DPIclimate/enviro-node/electronics/mounting/case-connector.kicad_pcb

## KiCad design electronics/mounting/case-connector.kicad_pcb (2022-11-08)

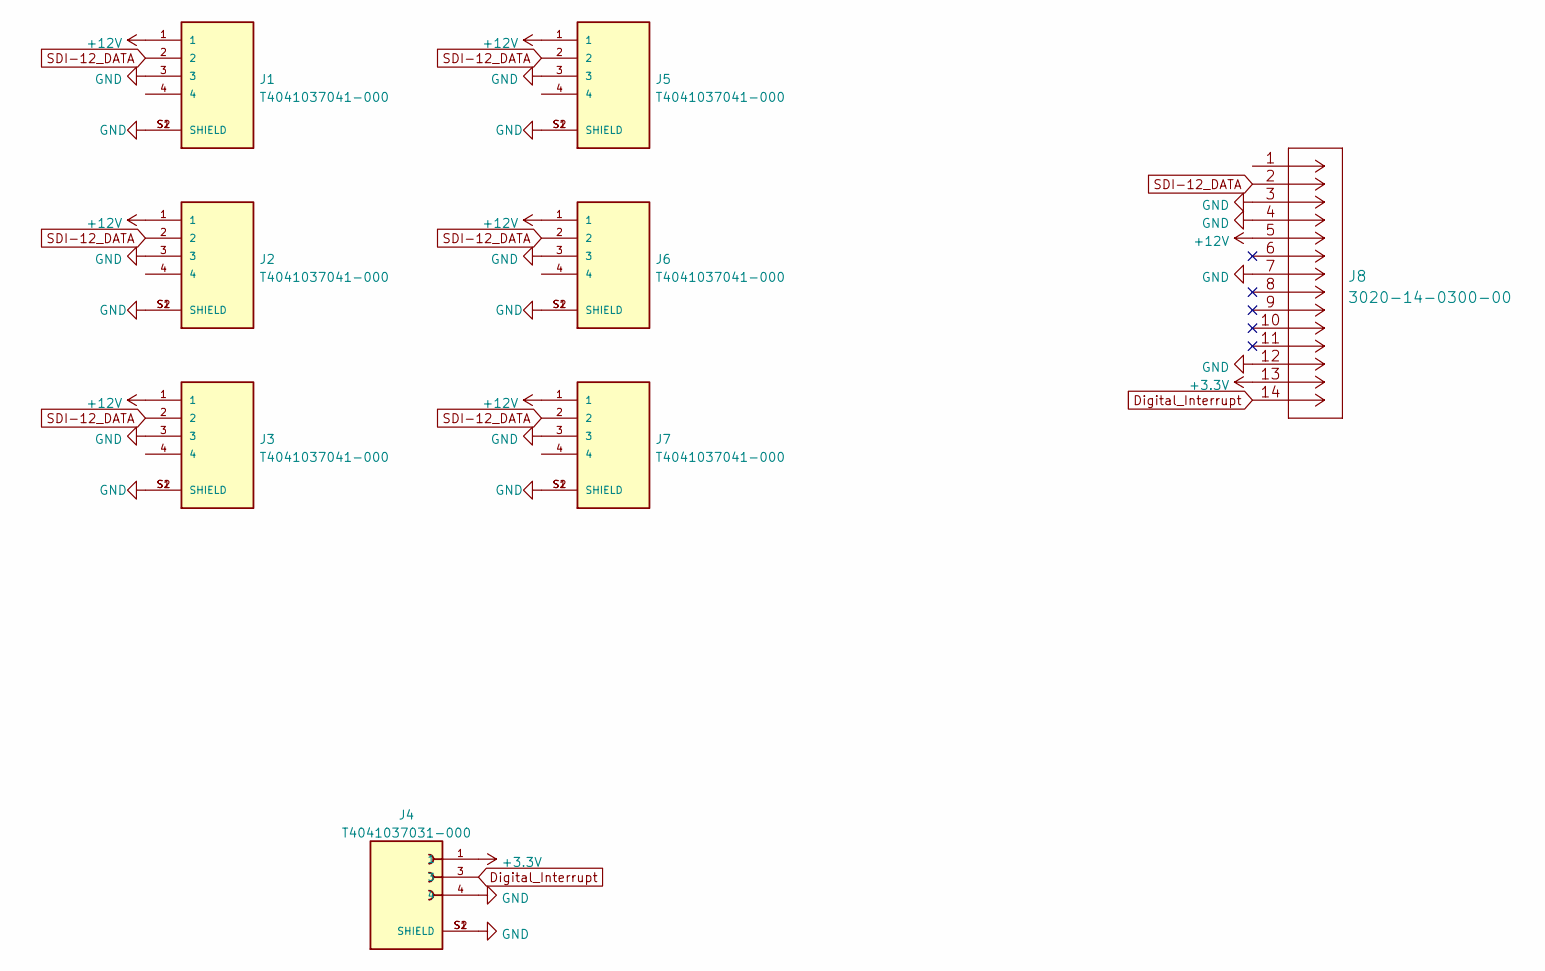
[picture p6: schematic case-connector.kicad_sch]

Parts:
J1, J2, J3, J5, J6, J7: T4041037041-000; TE_T4041037041-000
J4: T4041037031-000; TE_T4041037031-000
J8: 3020-14-0300-00

Connections:
+3.3V: J4.1, J8.13
+12V: J1.1, J2.1, J3.1, J5.1, J6.1, J7.1, J8.5
Digital_Interrupt: J4.3, J8.14
GND: J1.3, J1.S1 (SHIELD), J1.S2 (SHIELD), J2.3, J2.S1 (SHIELD), J2.S2 (SHIELD), J3.3, J3.S1 (SHIELD), J3.S2 (SHIELD), J4.4, J4.S1 (SHIELD), J4.S2 (SHIELD), J5.3, J5.S1 (SHIELD), J5.S2 (SHIELD), J6.3, J6.S1 (SHIELD), J6.S2 (SHIELD), J7.3, J7.S1 (SHIELD), J7.S2 (SHIELD), J8.3, J8.4, J8.7, J8.12
SDI-12_DATA: J1.2, J2.2, J3.2, J5.2, J6.2, J7.2, J8.2
