DPIclimate/enviro-node/electronics/mounting/case-connector.kicad_pcb

## KiCad design electronics/mounting/case-connector.kicad_pcb (continued)

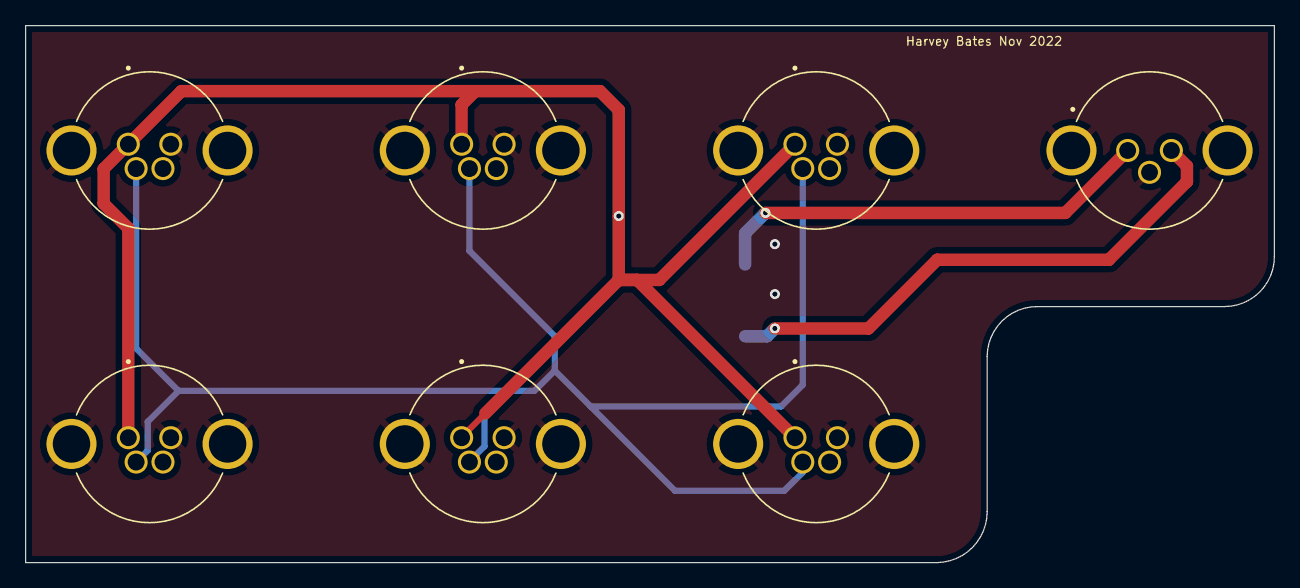
[picture p7: board case-connector.kicad_pcb from above]

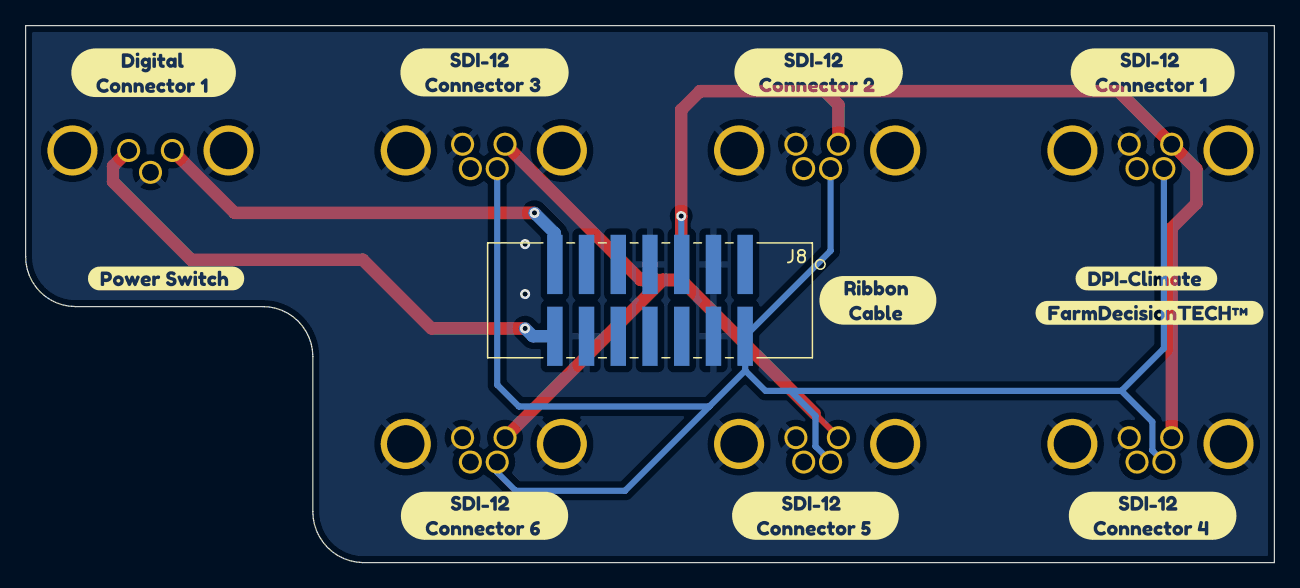
[picture p8: board case-connector.kicad_pcb from below]

Board: 2 copper layers, 100.0 x 43.0 mm, 19 parts (12 on the bottom side), 5 nets.

Other parts of the board:
kibuzzard-63638BF5: G***; kibuzzard-63638BF5
kibuzzard-63638C3D: G***; kibuzzard-63638C3D
kibuzzard-63638C4D: G***; kibuzzard-63638C4D
kibuzzard-63638C5F: G***; kibuzzard-63638C5F
kibuzzard-63638C46: G***; kibuzzard-63638C46
kibuzzard-63638C53: G***; kibuzzard-63638C53
kibuzzard-63638C59: G***; kibuzzard-63638C59
kibuzzard-63638CAD: G***; kibuzzard-63638CAD
kibuzzard-63638FDF: G***; kibuzzard-63638FDF
kibuzzard-6363901F: G***; kibuzzard-6363901F
kibuzzard-63639046: G***; kibuzzard-63639046
