DPIclimate/enviro-node/electronics/main-processor/nrf52840-breakout/nrf52840-breakout.kicad_pcb

## KiCad design electronics/main-processor/nrf52840-breakout/nrf52840-breakout.kicad_pcb (2022-09-23)

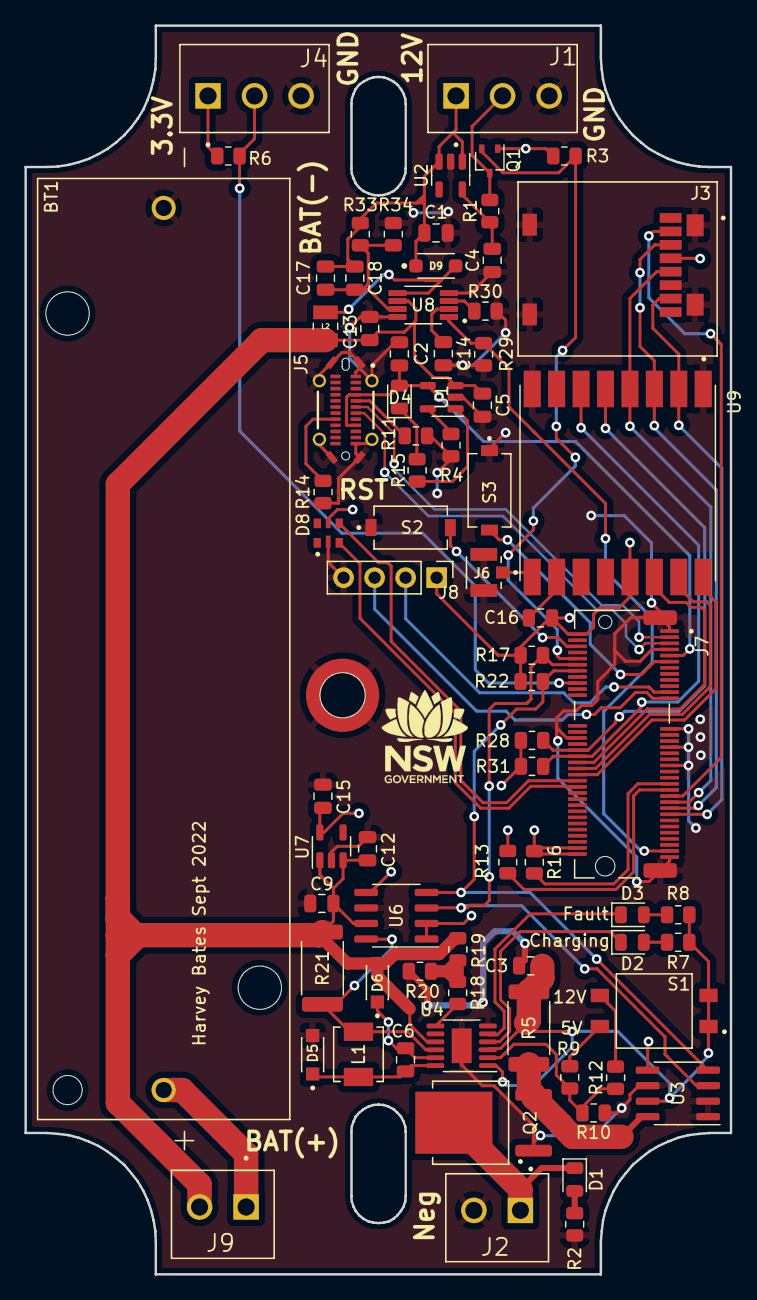
[picture p9: board nrf52840-breakout.kicad_pcb from above]

Board: 2 copper layers, 57.7 x 102.2 mm, 76 parts (0 on the bottom side), 58 nets.

Parts:
BT1: 1043; BAT_1043
C1, C4, C6, C12, C15: 1uF; C_0805_2012Metric
C2, C5: 4.7uF; C_0805_2012Metric
C3, C9, C13, C16, C18: 10uF; C_0805_2012Metric
C14: 0.01uF; C_0805_2012Metric
C17: 100pF; C_0805_2012Metric
D1, D3: LED(Red); LED_0805_2012Metric
D2: LED(Green); LED_0805_2012Metric
D4: LED; LED_0805_2012Metric
D5, D6: SS34LW_RVG; SODFL3718X102N
D8: BB-2020BGR-TRB; LED_BB-2020BGR-TRB
D9: D_Schottky; SODFL3718X108N
J1, J4: TBP02R2-381-03BE; CUI_TBP02R2-381-03BE
J2, J9: TBP02R2-381-02BE; CUI_TBP02R2-381-02BE
J3: ST1W008S4AR1500; JAE_ST1W008S4AR1500
J5: USB4070-30-C_REVC5; USB4070-30-C
J6: CONUFL001-SMD-T; LINX_CONUFL001-SMD-T
J7: 21992304; TE_21992304
J8: Conn_01x04_Male; PinHeader_1x04_P2.54mm_Vertical
L1: SRP4020T-5R6M; IND_SRP4020TA-5R6M
L2: CBC2518T100M; INDC2518X200N
MP1: 9774025151R; WE_9774025151R
Q1: BSS214NW; SOT-323_SC-70
Q2: AOD417; DPAK228P994X240_3N
R1, R3, R30: 10K; R_0805_2012Metric
R2, R6, R7, R8, R13, R16, R17, R22: 4.7K; R_0805_2012Metric
R4: 3.2K; R_0805_2012Metric
R5, R21: 0.1; R_2512_6332Metric
R9: 23K; R_0805_2012Metric
R10: 27K; R_0805_2012Metric
R11, R14: 5.1K; R_0805_2012Metric
R12: 53.6K; R_0805_2012Metric
R15: 680; R_0805_2012Metric
R18: 191K; R_0805_2012Metric
R19: 70K; R_0805_2012Metric
R20: 330K; R_0805_2012Metric
R28, R31: 100K; R_0805_2012Metric
R29: 1M; R_0805_2012Metric
R33: 50K; R_0805_2012Metric
R34: 5K; R_0805_2012Metric
S1: DS04-254-2-02BK-SMT; SW_DS04-254-2-02BK-SMT
S2: RST; SW_PTS636_SM43J_SMTR_LFS
S3: BOOT; SW_PTS636_SM43J_SMTR_LFS
U1: MCP73832-2-OT; SOT-23-5
U2: NCP718xSN500; SOT-23-5
U3, U6: INA219BxD; SOIC-8_3.9x4.9mm_P1.27mm
U4: LT3652IMSE; MSOP-12-1EP_3x4mm_P0.65mm_EP1.65x2.85mm
U7: LD39015M33R; SOT-23-5
U8: MIC2145BMM
U9: RFM95W-915S2; XCVR_RFM95W-915S2

Connections:
+3.3V: C15.1, C16.1, D8.5 (VCC), J3.4, J4.1, J7.2, J7.72, J7.74, J8.1, Q1.1 (G), R3.1, R6.2, R13.1, R16.1, R17.1, R22.1, R28.2, R31.2, U3.5 (VS), U6.1 (A1), U6.2 (A0), U6.5 (VS), U7.5 (OUT), U9.13 (3.3V)
+5VP: C4.1, R1.1, U2.5 (OUT)
+12V: C1.1, C17.1, C18.1, D9.1 (K), J1.1, R33.2, U2.1 (IN), U2.3 (EN)
BAT(+): BT1.P, J9.1
BOOT: J7.11, S3.2
D0: J7.10, Q1.2 (S), R3.2
D1: J4.2, J7.18, R6.1
GND: BT1.N, C1.2, C2.2, C3.2, C4.2, C5.2, C9.2, C12.2, C13.2, C14.2, C15.2, C16.2, D5.A, D8.2 (GND), J1.3, J2.2, J3.6, J3.GND1 (GND), J3.GND2 (GND), J3.GND3 (GND), J3.GND4 (GND), J4.3, J5.A1 (GND_A), J5.A12 (GND_A), J5.S1 (SHIELD), J5.S2 (SHIELD), J5.S3 (SHIELD), J5.S4 (SHIELD), J5.S5 (SHIELD), J5.S6 (SHIELD), J5.S7 (SHIELD), J5.S8 (SHIELD), J6.2, J6.3, J7.1, J7.7, J7.33, J7.36, J7.39, J7.45, J7.75, J7.S1 (SHIELD), J7.S2 (SHIELD), J8.4, MP1.1, Q2.1, R2.2, R4.1, R10.2, R11.2, R14.1, R20.1, R29.1, R30.1, R34.1, S2.1, S3.1, U1.2 (VSS), U2.2 (GND), U3.1 (A1), U3.2 (A0), U3.6 (GND), U4.6 (TIMER), U4.13 (GND), U6.6 (GND), U7.2 (GND), U8.4 (PGND), U8.8 (SGND), U9.1 (GND), U9.8 (GND), U9.10 (GND)
GPIO0: J7.40, R28.1, U9.5 (NSS)
GPIO1: J7.42, R31.1, U9.6 (RESET)
GPIO2: J7.44, U9.14 (DIO0)
GPIO3: J7.46, U9.15 (DIO1)
GPIO4: J7.48, U9.16 (DIO2)
GPIO5: J7.73, R29.2, U8.1 (En)
I2C_SCL: J7.14, R22.2, U3.4 (SCL), U6.4 (SCL)
I2C_SCL1: J7.53, R13.2
I2C_SDA: J7.12, R17.2, U3.3 (SDA), U6.3 (SDA)
I2C_SDA1: J7.51, R16.2
unnamed: C3.1, R5.2, R7.1, R8.1, S1.1A, S1.2A, U3.7 (IN-), U4.1 (VIN), U4.3 (~SHDN)
unnamed: C6.1, D5.C, L1.1, U4.12 (SW)
unnamed: C6.2, D6.C, U4.11 (BOOST)
unnamed: C14.1, U8.2 (SS)
unnamed: C17.2, C18.2, R33.1, R34.2, U8.7 (FB)
unnamed: D1.1 (K), J2.1, Q2.4
unnamed: D1.2 (A), R2.1
unnamed: D2.1 (K), U4.4 (~CHRG)
unnamed: D2.2 (A), R7.2
unnamed: D3.1 (K), U4.5 (~FAULT)
unnamed: D3.2 (A), R8.2
unnamed: D4.1 (K), R15.2
unnamed: D9.2 (A), L2.2, U8.5 (SW)
unnamed: J1.2, Q1.3 (D), R1.2
unnamed: J5.A5 (CC1), R11.1
unnamed: J5.B5 (CC2), R14.2
unnamed: J6.1, U9.9 (ANT)
unnamed: L1.2, R21.1, U4.10 (SENSE), U6.8 (IN+)
unnamed: Q2.3, R5.1, U3.8 (IN+)
unnamed: R4.2, U1.5 (PROG)
unnamed: R9.1, S1.1B
unnamed: R9.2, R10.1, R12.2, U4.2 (VIN_REG)
unnamed: R12.1, S1.2B
unnamed: R15.1, U1.1 (STAT)
unnamed: R18.1, R19.1, R20.2
unnamed: R18.2, U4.7 (VFB)
unnamed: R30.2, U8.3 (RSET)
PDM_CLK: D8.4 (CI), J7.50
PDM_DATA: D8.3 (DI), J7.52
RESET: J7.6, S2.2
SPI_CS: J3.2, J7.55
SPI_MISO: J3.7, J7.61, U9.2 (MISO)
SPI_MOSI: J3.3, J7.59, U9.3 (MOSI)
SPI_SCK: J3.5, J7.57, U9.4 (SCK)
SWDCLK: J7.21, J8.2
SWDIO: J7.23, J8.3
USB_D+: J5.A6 (DP1), J7.3
USB_D-: J5.A7 (DN1), J7.5
VBAT: C5.1, C9.1, C12.1, C13.1, D6.A, J9.2, L2.1, R19.2, R21.2, U1.3 (VBAT), U4.9 (BAT), U6.7 (IN-), U7.1 (IN), U7.3 (EN), U8.6 (VDD)
VBUS: C2.1, D4.2 (A), J5.A4 (VBUS_A), J5.A9 (VBUS_A), J7.9, U1.4 (VDD)
